SP5GW/HF_Probe/docs/FullWaveRectifierDescription.pdf

U,"C
+0 | UrF

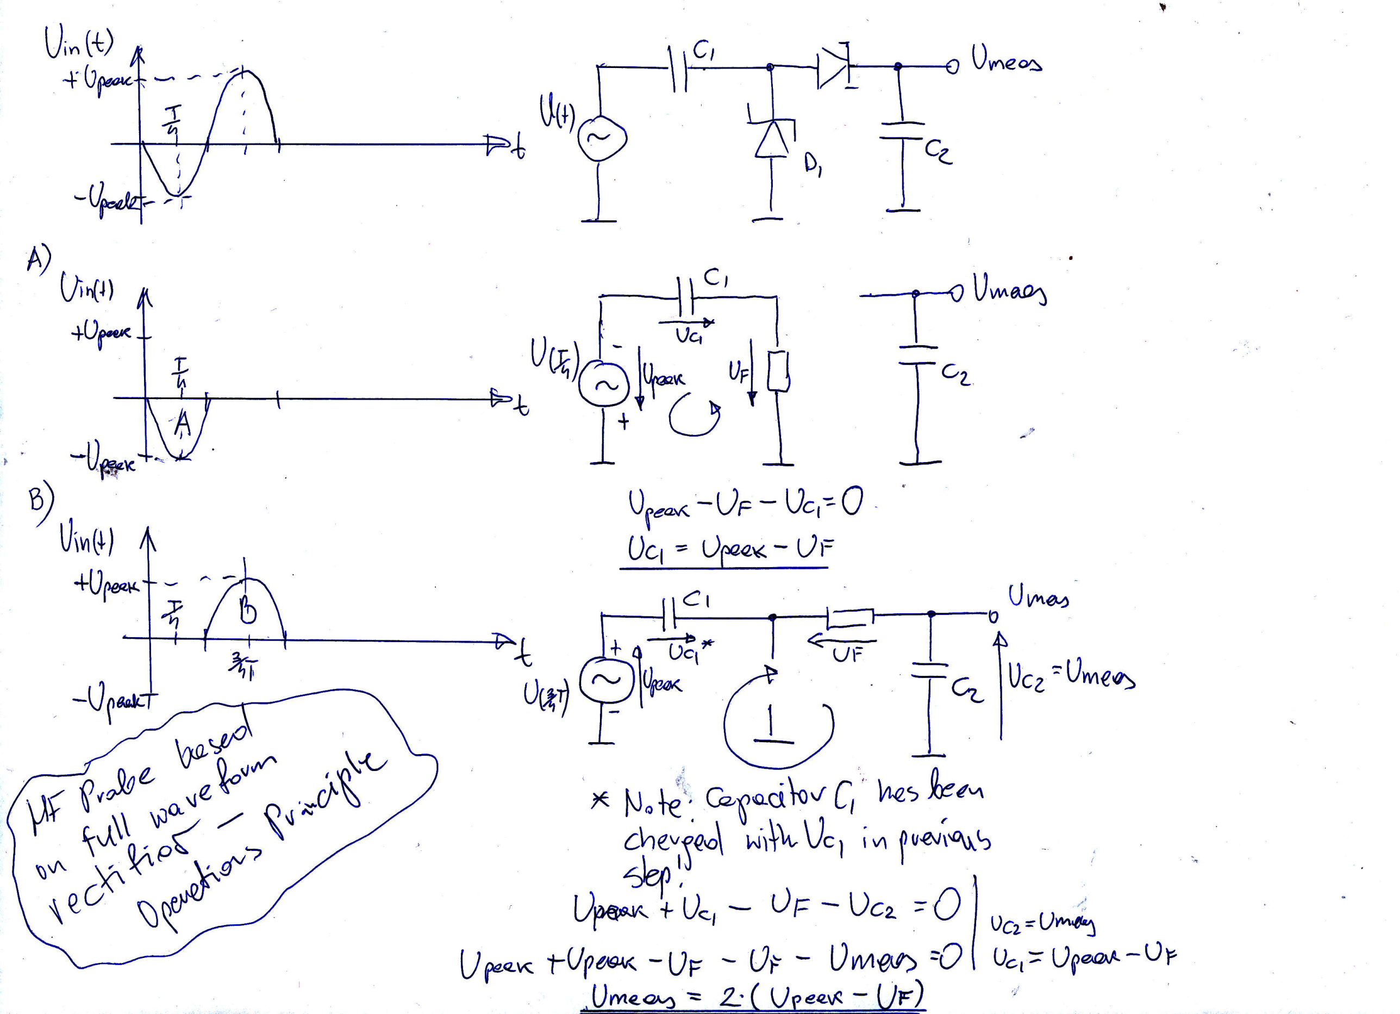
[picture p11: page 1]

I

U^u*

A)' (ln(t)

+Ut*"

-r)

v.w,*
s)
' Ui'(ł)

# -T"U*uą

Utn*,
0

# ffi

'-ę%-l1

Uęaon< -Or _ U.,

## Urt -- OPo*- l)

T.,

I

I

t-? -l-

=0

l=
+Uf.'"

## x N," ę'' o"'p*lo ' C,' V'ąs knn

## cpei1ed "^łt"U.' i" 1lue"i\g i

### ffiQ"" ,pJ1 u., - dr - l)cz =O I *, =t)ry

l) pno* yUpł,err' -l)r - UF' - l)ugn =ol U.F Oę"'o^*-Up
,u-"ą= zrvę""a-r ';

6".5J;.,: -.v

# Y: Wź'\u-d ,\no'rV
