SP5GW/HF_Probe/ltspice/HF_Probe_FullWaveRectifier.asc

C1: cap; 100n
C2: cap; 100n
D1: schottky; BAT54
D2: schottky; BAT54
HFSignal: signal; SINE(0 3 10000)0; AC 3
Named nets: 0, Umeas, Ut
.tran 20ms
In actual design BAT64 diodes were used.
