SP5GW/HF_Probe/ltspice/HF_Probe_HalfWaveRectifier.asc

C1: cap; 1n
C2: cap; 4.6n
D1: schottky; BAT54
HFSignal: signal; SINE(0 5 100k); AC 1
R1: res; 10k
Named nets: 0, Vout, Vin
.tran 100ms
