SP5GW/HF_Probe/(commit log)

2023-10-28 power measurement chapter started
2023-10-28 Power calculation and measurement section updated
2023-11-11 Power meas. conclusions corrected
