SP5GW/HF_Probe/img/step2_solderingcircuit_1.jpg

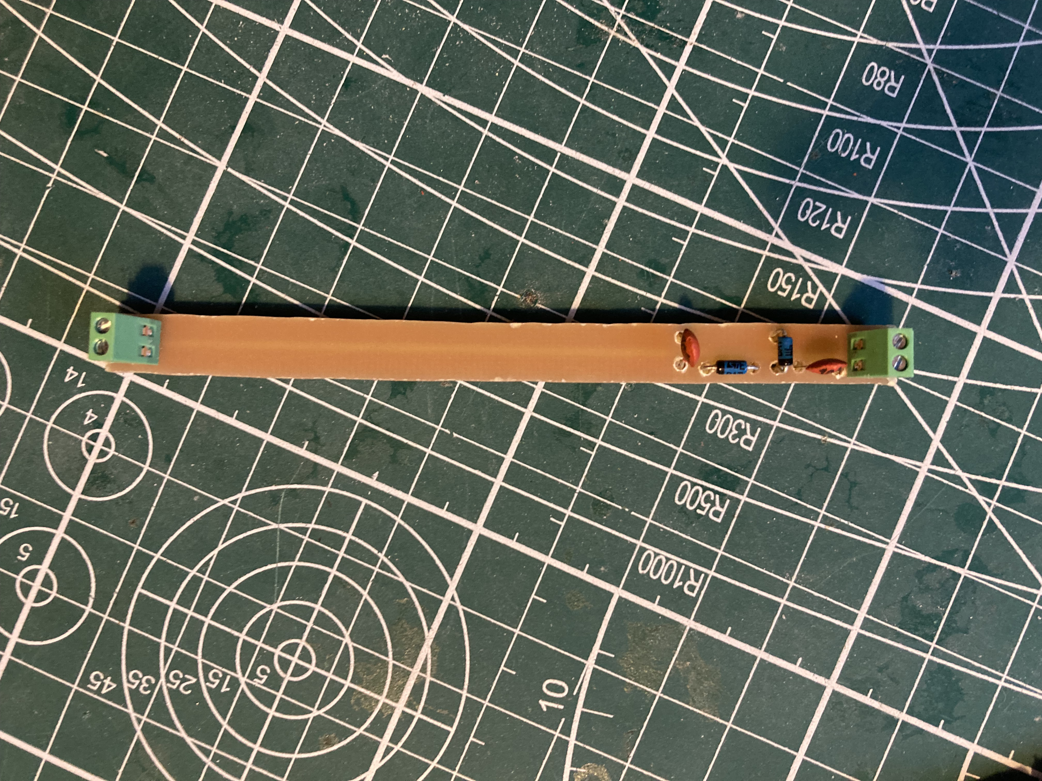
[picture p4: img/step2_solderingcircuit_1.jpg]
img/step2_solderingcircuit_1.jpg
