SP5GW/HF_Probe/img/step2_solderingcircuit_2.jpg

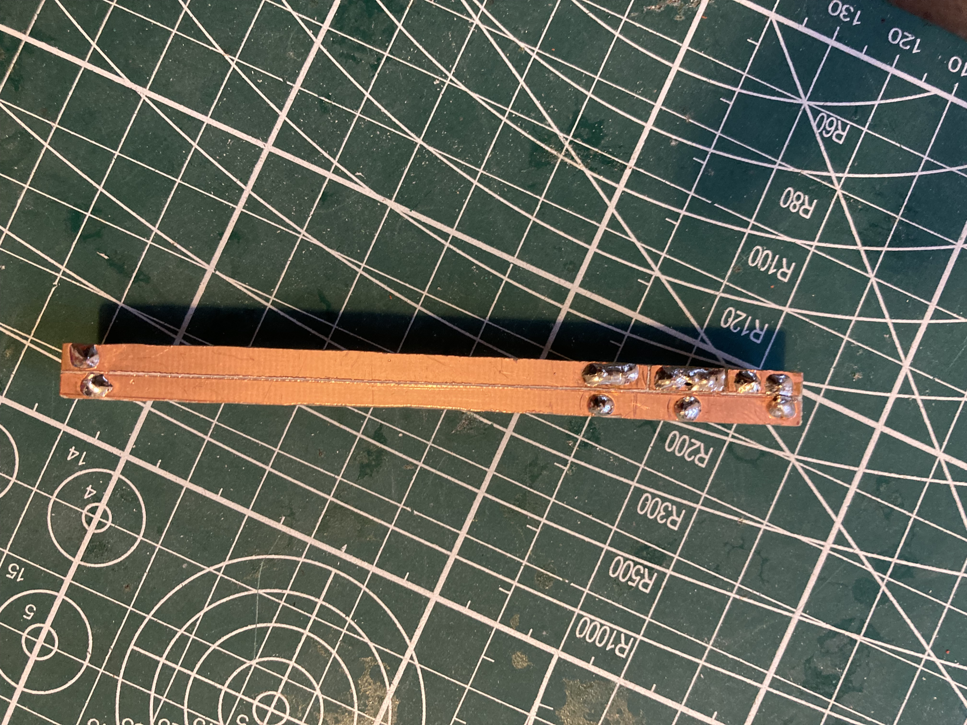
[picture p5: img/step2_solderingcircuit_2.jpg]
img/step2_solderingcircuit_2.jpg
