SP5GW/HF_Probe/img/step3_securinggroundprobe.jpg

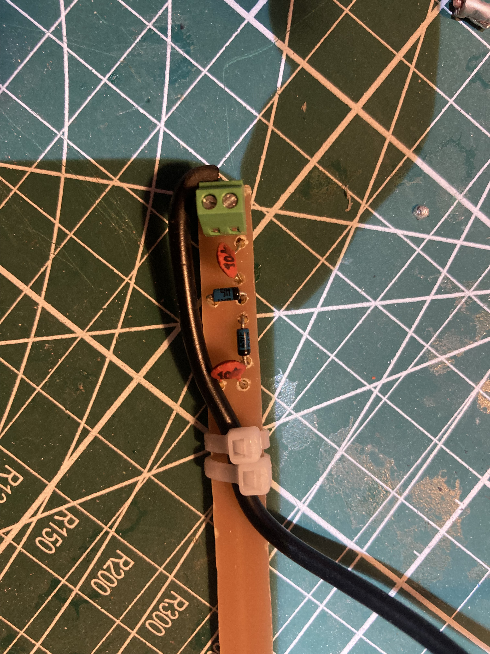
[picture p6: img/step3_securinggroundprobe.jpg]
img/step3_securinggroundprobe.jpg
