SP5GW/HF_Probe/img/step4_attachingnidle_2.jpg

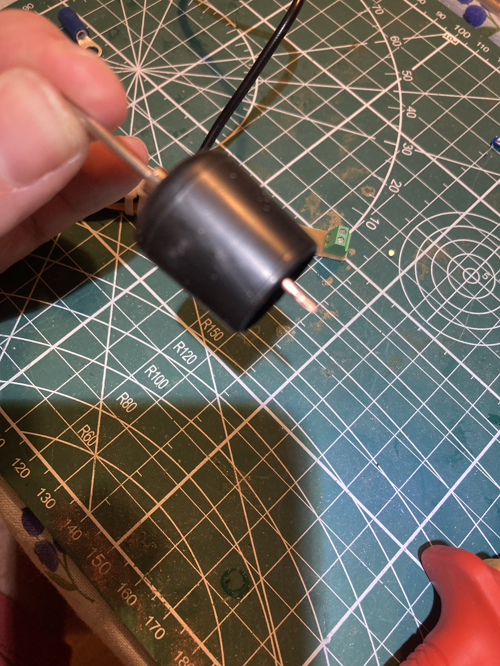
[picture p8: img/step4_attachingnidle_2.jpg]
img/step4_attachingnidle_2.jpg
