SP5GW/HF_Probe/img/step5_tubemounting.jpg

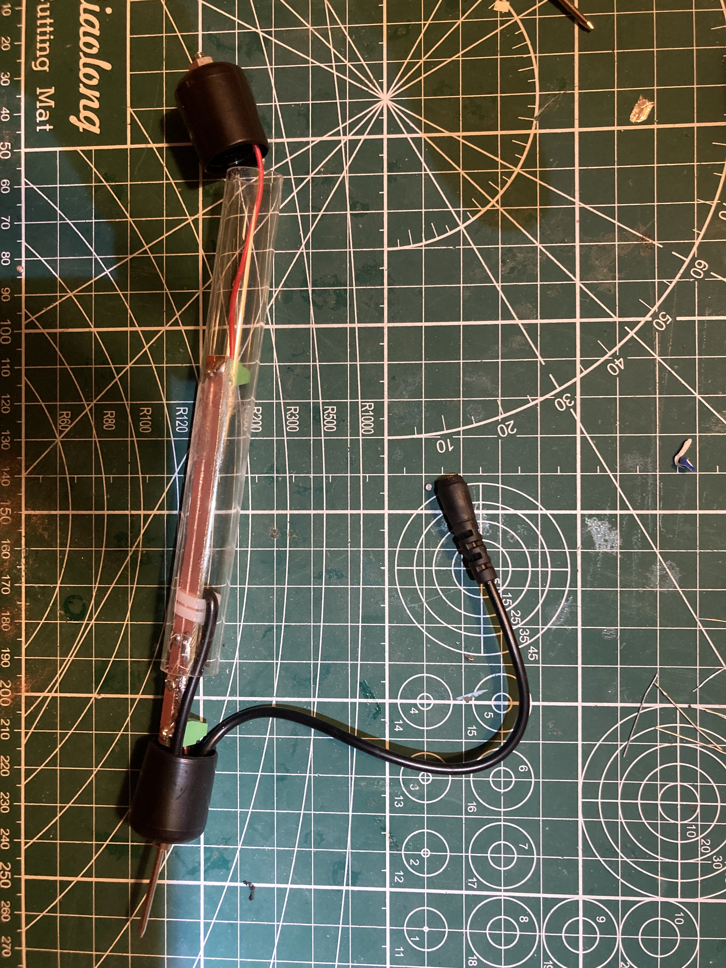
[picture p9: img/step5_tubemounting.jpg]
img/step5_tubemounting.jpg
