SP5GW/HF_Probe/img/step6_finishedproduct.jpg

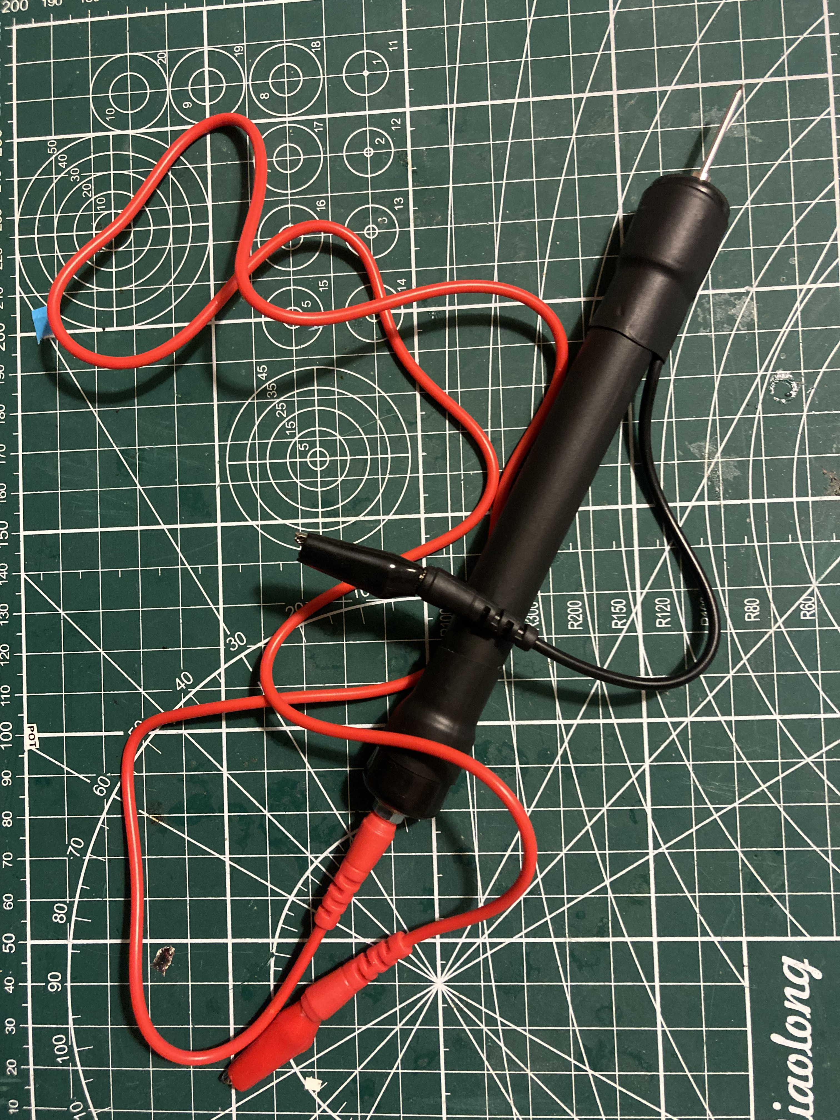
[picture p10: img/step6_finishedproduct.jpg]
img/step6_finishedproduct.jpg
